fangyutin/crane_hardware/PCB_back_side.jpg

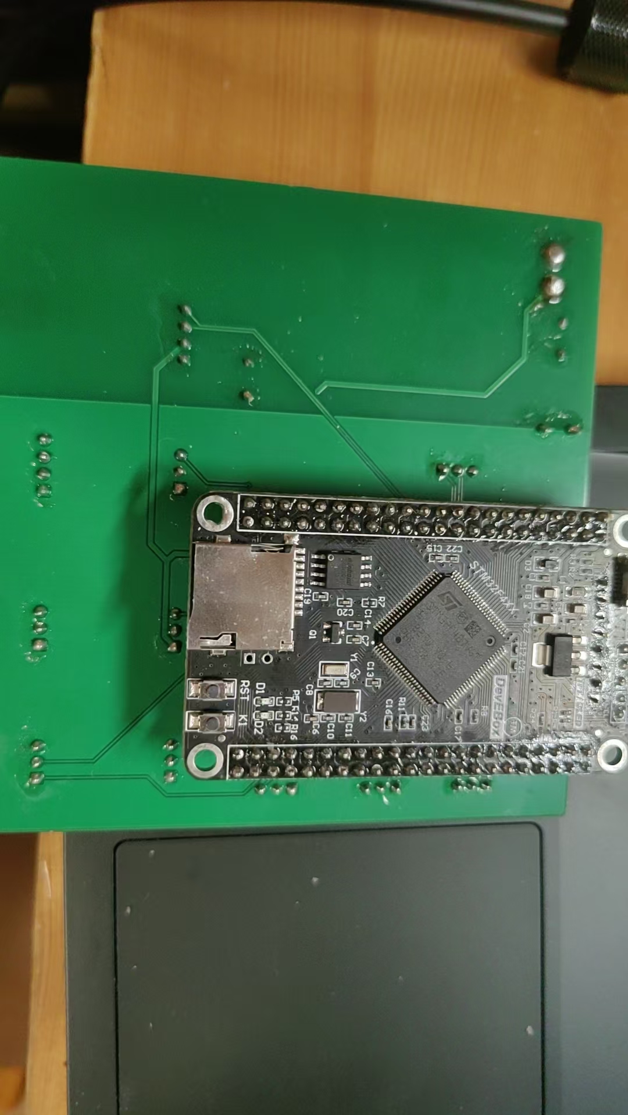
PCB_back_side.jpg
