fangyutin/crane_hardware/Breakout_board.jpg

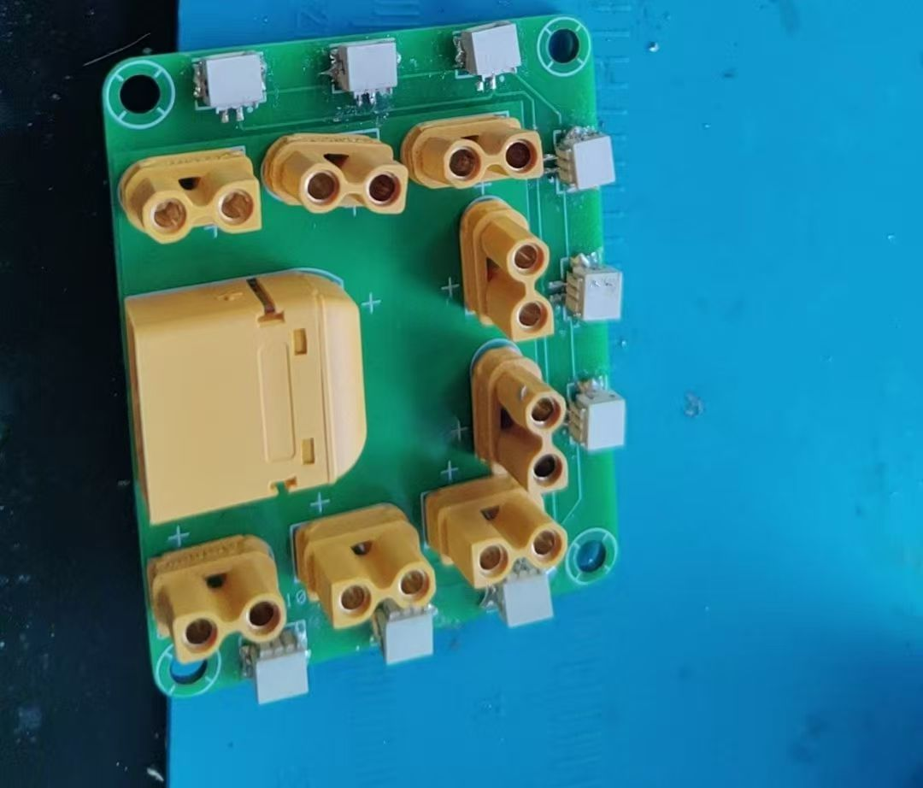
Breakout_board.jpg
