fangyutin/crane_hardware/README.md

# crane_hardware
PCB
根据电控的需求，我前后绘制了三版PCB，第二版添加了can口，第三版添加了5V的输出接口和两个引脚的接口。同时，我前后焊接了五六块PCB，五六块分线板。（提前焊了几块备用的带去上海）（虽然最后一块都没用）

# 1. 简述设计依据
设计一个将STM32F4单片机所需引脚引出，并集成电压转换功能的倒插板。

**电源分区设计**：利用分线板，将24V航模电池电压分成若干个24V接口（分线板上其他24V输出可以同时为大疆电机等供电），再利用两个24V转5V的降压模块，分别使出5V的VOUT_H和VOUT_L，VOUT_H为舵机供电，VOUT_L为MCU、can、激光雷达等供电。防止舵机产生反电动势烧掉MCU

**MCU核心控制**：以STM32F4为中心，引出其所有必要的I/O引脚，通过排针/排母实现牢固清晰的接线。

# 2. 简述Layout想法
**分区布局**
1）电源区域：24V输入接口、降压模块、滤波电容集中放置在一个区域，形成清晰的电源转换路径。
2）接口区域：将引出的排针布置在板卡边缘，并尽量按功能分组（如舵机接口组、激光雷达接口组），方便接线。
3）有效利用PCB的正反面，将倒插部分放置于板的背面。

**布线策略**
1）电源线：为承受较大电流，采用了30mil的较粗的走线，同时尽量使其走线较短较直，以减小线路阻抗和压降。
2）信号线：采用10mil的较细的走线，同时避免与较大电流线平行走线，减小线路阻抗。
3）GND：采取正面大面积铺铜接地
4）VOUT_H：由于较分散接线困难，采取背面大面积铺铜接VOUT_H。
5）设置若干通孔，控制电流回路、降低阻抗，提高在大电流负载下的稳定性和抗干扰能力。

# 3. 简述焊接问题
1）焊接要点：XT30、XT60公母头的焊接，用烙铁头加热连接器的焊杯和焊锡，让焊锡自然熔化并流入、填满焊杯。
2）焊接降压模块时，需将焊锡覆盖上端的通孔，从通孔流到底层与PCB紧密接触。焊接完成后可以用万用表测是否有将不同引脚意外焊在一起。
3）焊接分线板时，烙铁很容易融化can口（1.54 2pin贴片），注意购买合适尺寸的不然很难焊）
4）风枪焊接贴片电阻时，在PCB上高1cm的位置垂直向下吹（不垂直很容易吹跑贴片电阻）

# 4. 简述焊接温度
1）焊接插件电阻、排针等通孔元件时，烙铁设置温度在330°C左右。
2）焊接XT30、XT60时，提高烙铁温度至380°C左右，高温快速焊接完（因为XT30的金属区域导热速度快，带走温度对焊锡熔化有影响，且周围是易融化的塑料，提高温度可以减少焊接时间；同时一口气焊完更容易得到好看的焊锡形状，多次焊接，烙铁难熔化已有的大量焊锡，且易产生尖刺等不好的焊锡形状）
