fangyutin/crane_hardware/PCB_front_side.jpg

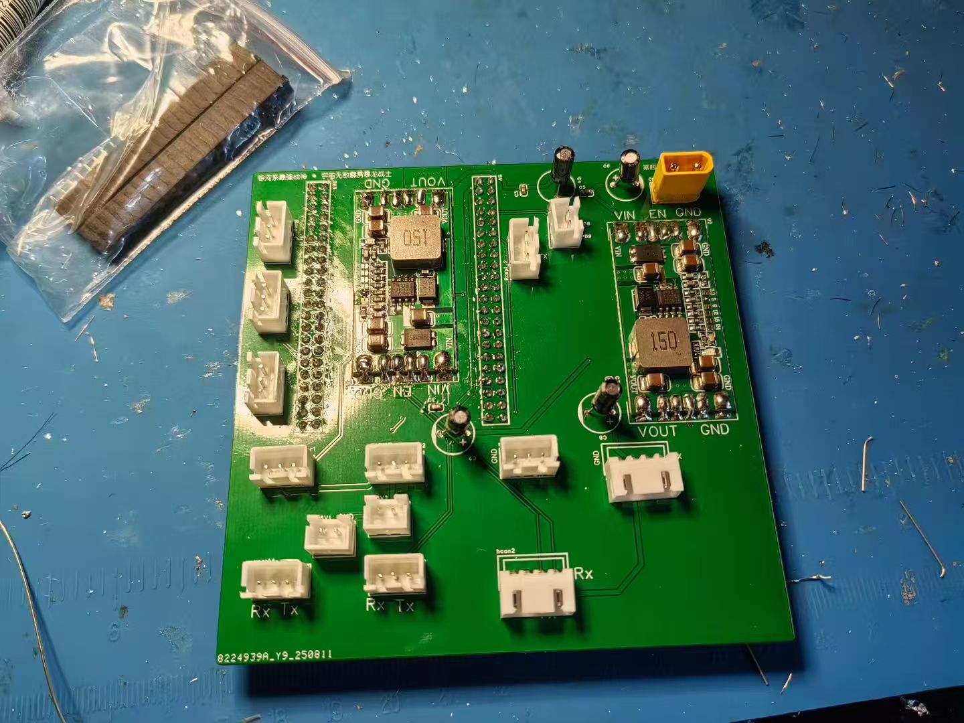
PCB_front_side.jpg
