fangyutin/crane_hardware/(list of files, drawings)

Other design files:
inverted_board0.eprj
inverted_board1.eprj
inverted_board2.eprj
