fangyutin/crane_hardware/(commit log)

2025-08-28 used for checking
    [inverted_board0.eprj, inverted_board1.eprj, inverted_board2.eprj]
2025-08-29 实物照片
